AI-FanGe/A-Ball-Robot-based-on-Esp32/(list of files, cad)

Other CAD files:
Ball_Robot_Model.3dm
