AI-FanGe/A-Ball-Robot-based-on-Esp32/(commit log)

2026-06-14 Add ESP32 ball robot control suite
2026-06-14 3D model
    [Ball_Robot_Model.3dm]
